weigu1/Standalone-Eprom-Programmer/KiCAD/eprom_programmer_27c512/eprom_programmer_27c512.kicad_sch

## KiCad design KiCAD/eprom_programmer_27c512/eprom_programmer_27c512.kicad_sch (2023-03-30)

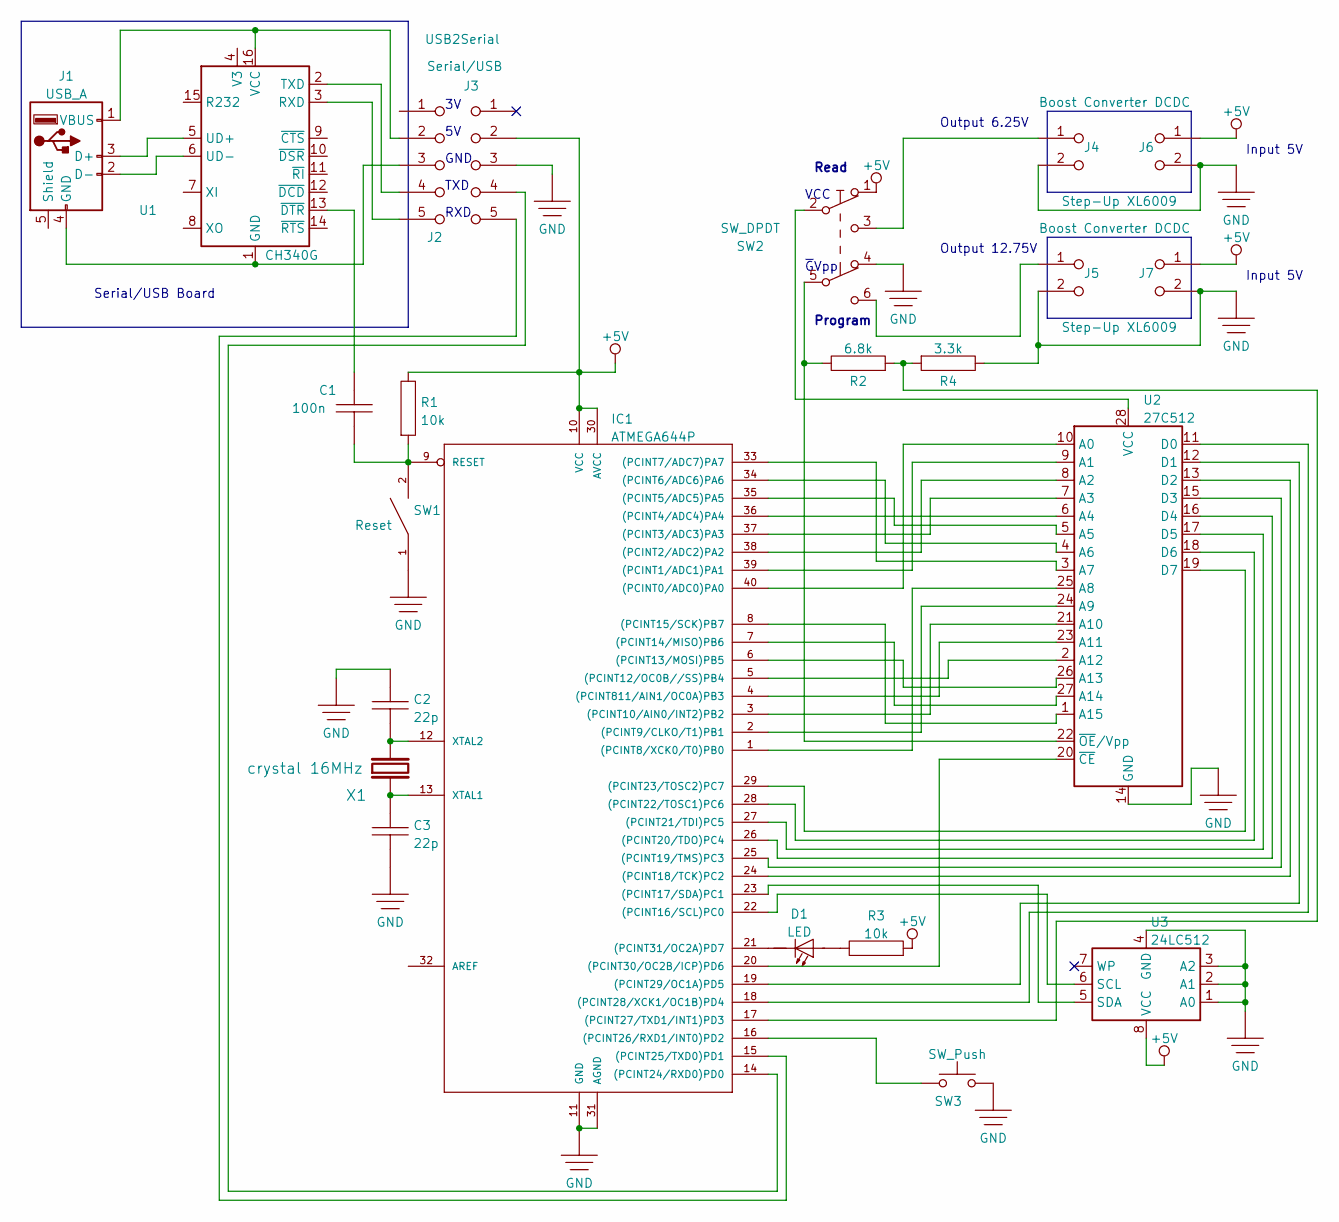
[picture p2: schematic eprom_programmer_27c512.kicad_sch]

Parts:
C1: 100n
C2, C3: 22p
D1: LED
IC1: ATMEGA644P; DIL40
J1: USB_A
J2: Serial/USB
J3: USB2Serial
J4, J5: Boost Converter DCDC
J6, J7: Step-Up XL6009
R1, R3: 10k
R2: 6.8k
R4: 3.3k
SW1: Reset
SW2: SW_DPDT
SW3: SW_Push
U1: CH340G; SOIC-16_3.9x9.9mm_P1.27mm
U2: 27C512; DIP-28_W15.24mm
U3: 24LC512
X1: crystal 16MHz

Connections:
+5V: IC1.10 (VCC), IC1.30 (AVCC), J3.2 (12), J6.1 (11), J7.1 (11), R1.2, R3.1, SW2.1 (A), U3.8 (VCC)
GND: C2.1, C3.2, IC1.11 (GND), IC1.31 (AGND), J3.3 (13), J4.2 (12), J5.2 (12), J6.2 (12), J7.2 (12), R4.2, SW1.1, SW2.4 (A), SW3.2, U2.14 (GND), U3.1 (A0), U3.2 (A1), U3.3 (A2), U3.4 (GND)
unnamed: C1.1, U1.13 (~DTR)
unnamed: C1.2, IC1.9 (RESET), R1.1, SW1.2
unnamed: C2.2, IC1.12 (XTAL2), X1.2
unnamed: C3.1, IC1.13 (XTAL1), X1.1
unnamed: D1., IC1.21 ((PCINT31/OC2A)PD7), R3.2
unnamed: IC1.1 ((PCINT8/XCK0/T0)PB0), U2.25 (A8)
unnamed: IC1.2 ((PCINT9/CLKO/T1)PB1), U2.24 (A9)
unnamed: IC1.3 ((PCINT10/AIN0/INT2)PB2), U2.21 (A10)
unnamed: IC1.4 ((PCINT811/AIN1/OC0A)PB3), U2.23 (A11)
unnamed: IC1.5 ((PCINT12/OC0B//SS)PB4), U2.2 (A12)
unnamed: IC1.6 ((PCINT13/MOSI)PB5), U2.26 (A13)
unnamed: IC1.7 ((PCINT14/MISO)PB6), U2.27 (A14)
unnamed: IC1.8 ((PCINT15/SCK)PB7), U2.1 (A15)
unnamed: IC1.14 ((PCINT24/RXD0)PD0), J3.4 (14)
unnamed: IC1.15 ((PCINT25/TXD0)PD1), J3.5 (15)
unnamed: IC1.16 ((PCINT26/RXD1/INT0)PD2), SW3.1
unnamed: IC1.17 ((PCINT27/TXD1/INT1)PD3), R2.1, R4.1
unnamed: IC1.18 ((PCINT28/XCK1/OC1B)PD4), U2.11 (D0)
unnamed: IC1.19 ((PCINT29/OC1A)PD5), U2.12 (D1)
unnamed: IC1.20 ((PCINT30/OC2B/ICP)PD6), U2.20 (~CE)
unnamed: IC1.22 ((PCINT16/SCL)PC0), U3.6 (SCL)
unnamed: IC1.23 ((PCINT17/SDA)PC1), U3.5 (SDA)
unnamed: IC1.24 ((PCINT18/TCK)PC2), U2.13 (D2)
unnamed: IC1.25 ((PCINT19/TMS)PC3), U2.15 (D3)
unnamed: IC1.26 ((PCINT20/TDO)PC4), U2.16 (D4)
unnamed: IC1.27 ((PCINT21/TDI)PC5), U2.17 (D5)
unnamed: IC1.28 ((PCINT22/TOSC1)PC6), U2.18 (D6)
unnamed: IC1.29 ((PCINT23/TOSC2)PC7), U2.19 (D7)
unnamed: IC1.33 ((PCINT7/ADC7)PA7), U2.3 (A7)
unnamed: IC1.34 ((PCINT6/ADC6)PA6), U2.4 (A6)
unnamed: IC1.35 ((PCINT5/ADC5)PA5), U2.5 (A5)
unnamed: IC1.36 ((PCINT4/ADC4)PA4), U2.6 (A4)
unnamed: IC1.37 ((PCINT3/ADC3)PA3), U2.7 (A3)
unnamed: IC1.38 ((PCINT2/ADC2)PA2), U2.8 (A2)
unnamed: IC1.39 ((PCINT1/ADC1)PA1), U2.9 (A1)
unnamed: IC1.40 ((PCINT0/ADC0)PA0), U2.10 (A0)
unnamed: J1.1 (VBUS), J2.2 (12), U1.16 (VCC)
unnamed: J1.2 (D-), U1.6 (UD-)
unnamed: J1.3 (D+), U1.5 (UD+)
unnamed: J1.4 (GND), J2.3 (13), U1.1 (GND)
unnamed: J2.4 (14), U1.2 (TXD)
unnamed: J2.5 (15), U1.3 (RXD)
unnamed: J4.1 (11), SW2.3 (C)
unnamed: J5.1 (11), SW2.6 (C)
unnamed: R2.2, SW2.5 (B), U2.22 (~OE/Vpp)
unnamed: SW2.2 (B), U2.28 (VCC)

Notes on the sheet:
Input 5V
Program
Output 6.25V
VCC
GND
RXD
Serial/USB Board
TXD
Read
~{G}Vpp
Output 12.75V
